gladish/esp32_bike_taillight/README.md

# bikelight
ESP32 Bike Rear Light

Watch the demo (https://www.youtube.com/watch?v=3QLlCa5cVGc)

<table>
  <tr>
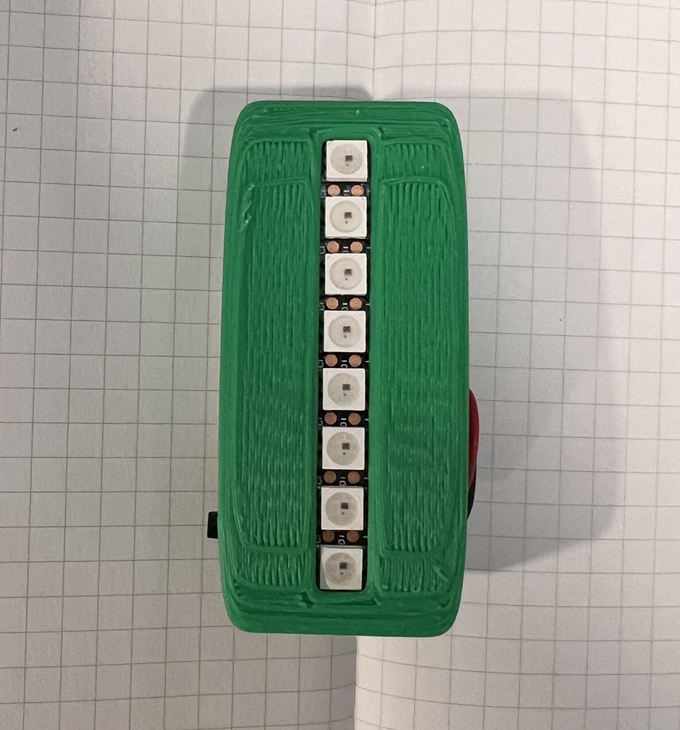
[picture p1: docs/bike_light_front.png]
    <td><br>Front</td>
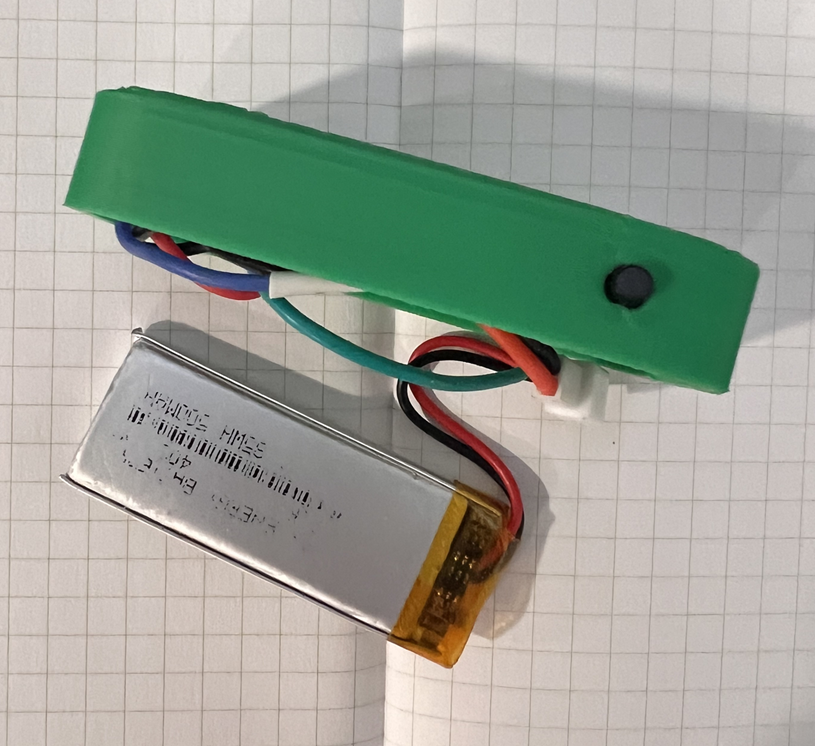
[picture p2: docs/bike_light_side.png]
    <td><br>Side</td>
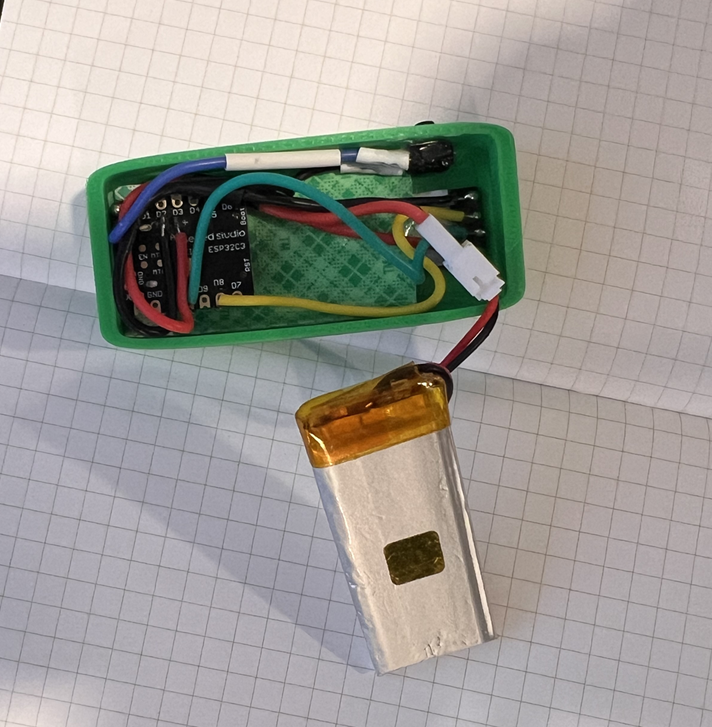
[picture p3: docs/bike_light_back.png]
    <td><br>Back</td>
  </tr>
</table>
