gladish/esp32_bike_taillight/hardware/bike_light_schematic.pdf

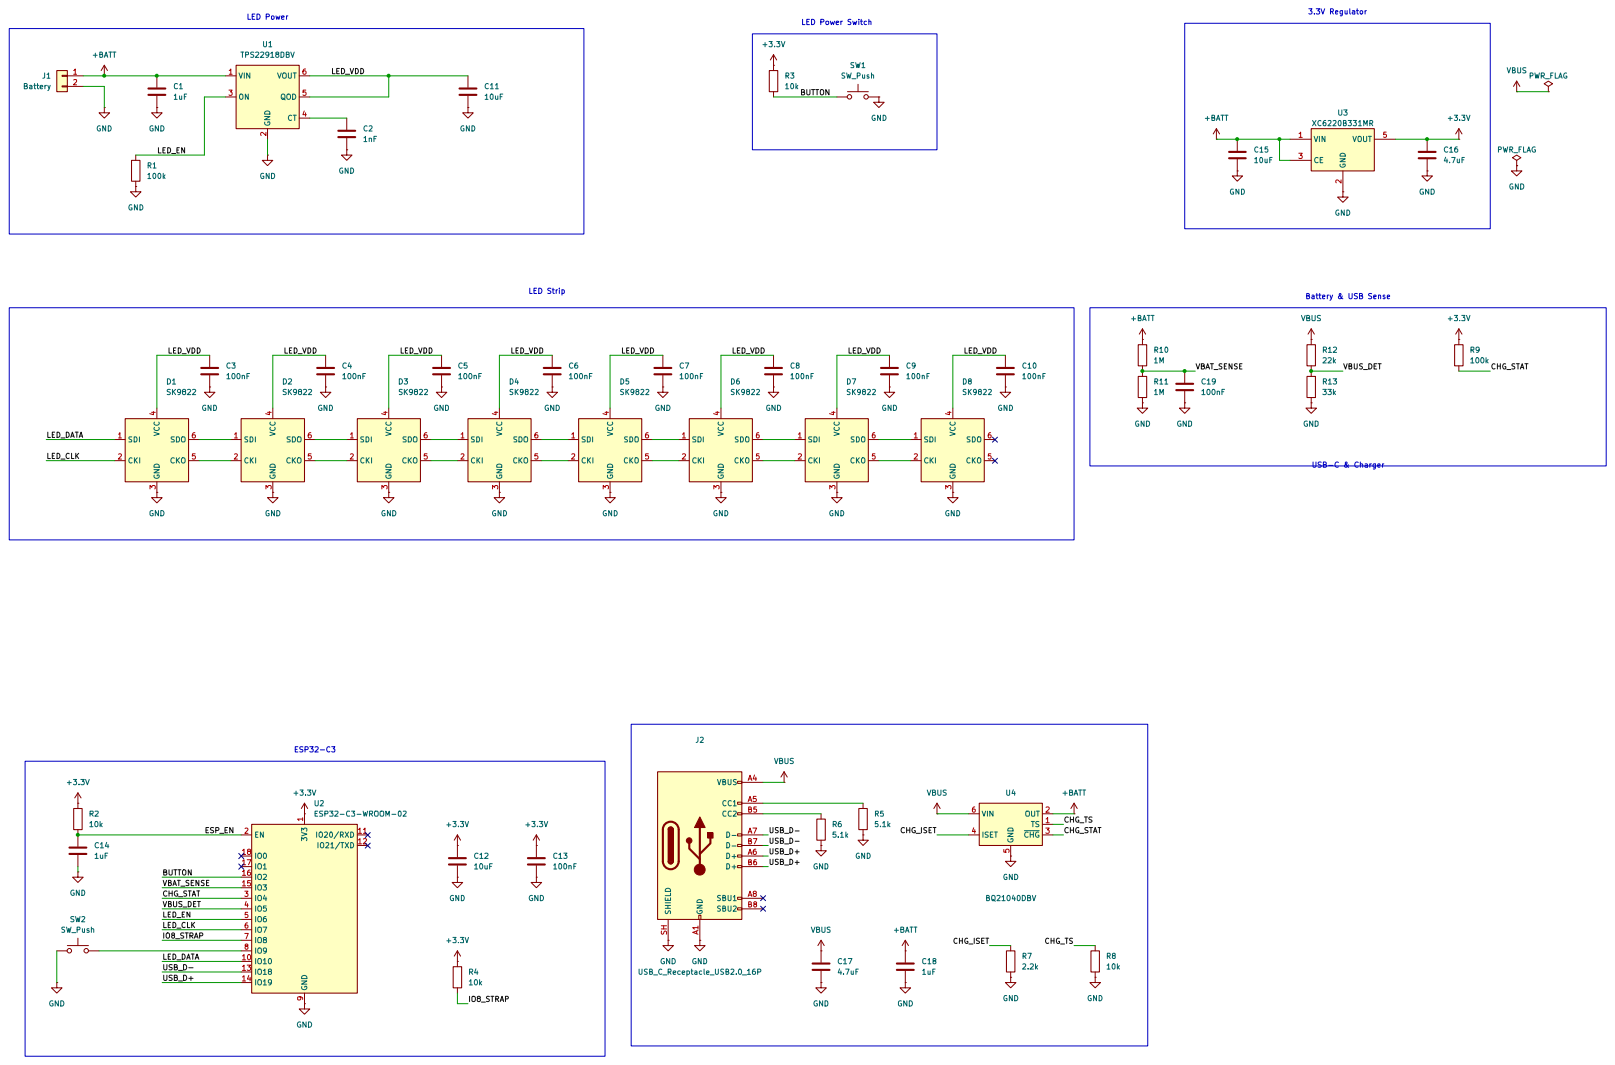
[picture p4: page 1]
