gladish/esp32_bike_taillight/hardware/bike_light/bike_light.kicad_pcb

## KiCad design hardware/bike_light/bike_light.kicad_pcb (2026-10-22)

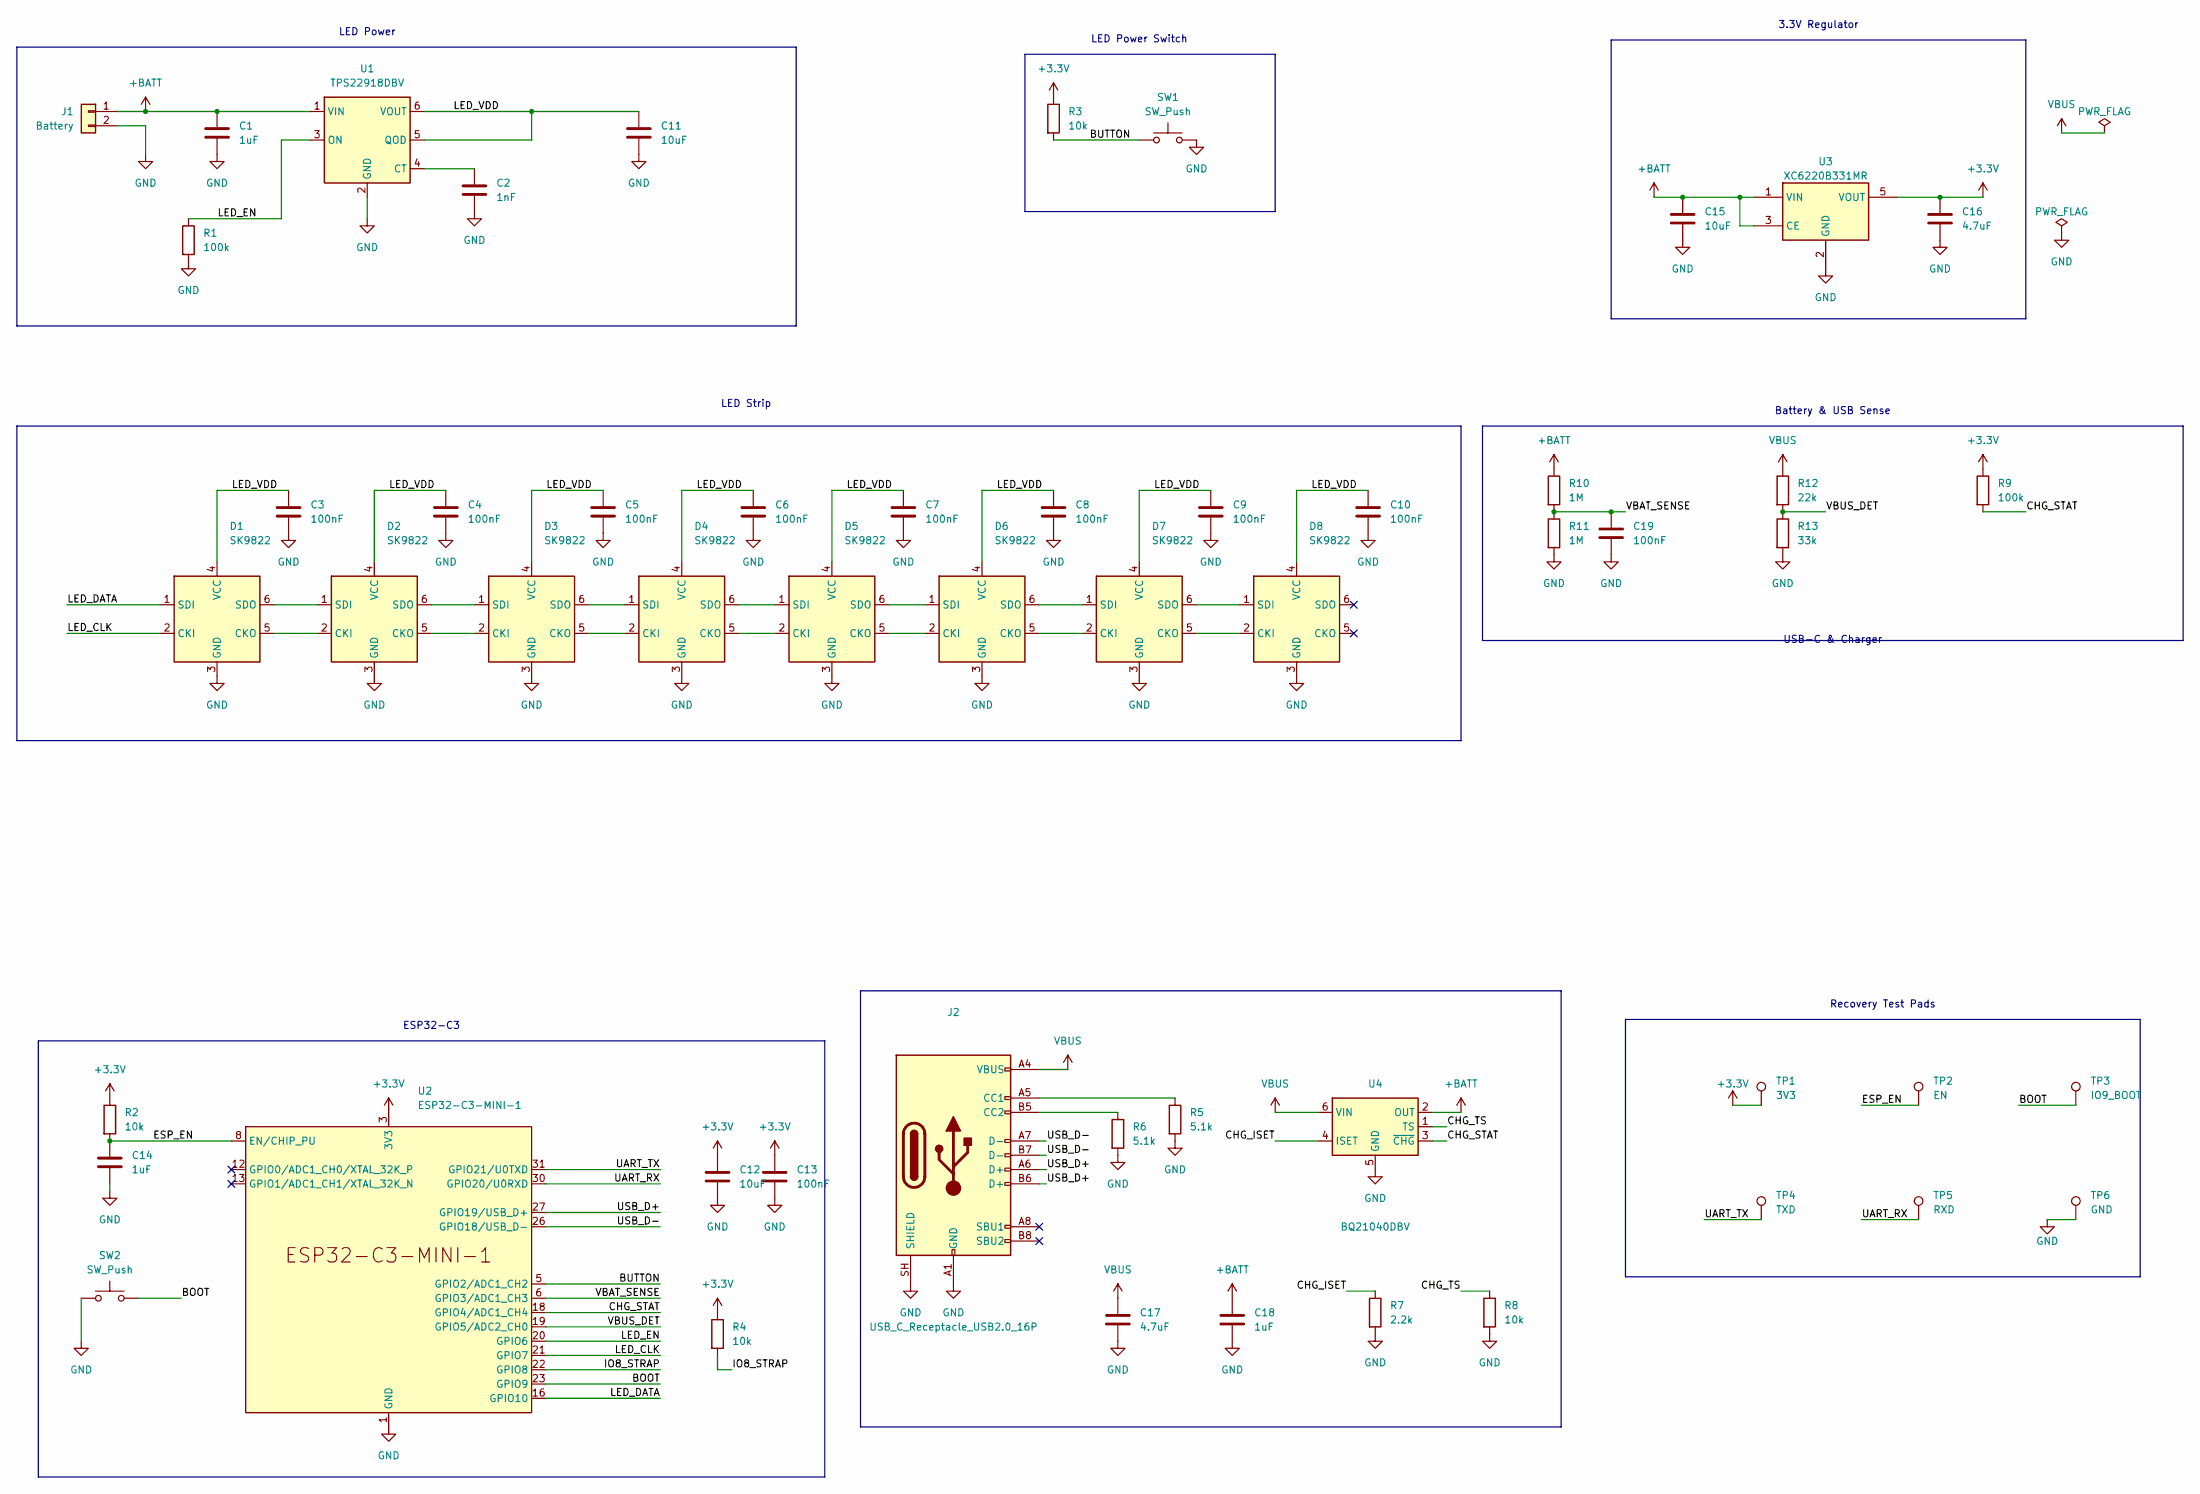
[picture p5: schematic bike_light.kicad_sch, gladish_bl]

Parts:
C1, C14, C18: 1uF; C_0402_1005Metric
C2: 1nF; C_0402_1005Metric
C3, C4, C5, C6, C7, C8, C9, C10, C13, C19: 100nF; C_0402_1005Metric
C11, C12, C15: 10uF; C_0603_1608Metric
C16, C17: 4.7uF; C_0603_1608Metric
D1, D2, D3, D4, D5, D6, D7, D8: SK9822; LED_RGB_5050-6
J1: Battery; JST_SH_SM02B-SRSS-TB_1x02-1MP_P1.00mm_Horizontal
J2: USB_C_Receptacle_USB2.0_16P; USB_C_Receptacle_HRO_TYPE-C-31-M-12
R1, R9: 100k; R_0402_1005Metric
R2, R3, R4, R8: 10k; R_0402_1005Metric
R5, R6: 5.1k; R_0402_1005Metric
R7: 2.2k; R_0402_1005Metric
R10, R11: 1M; R_0402_1005Metric
R12: 22k; R_0402_1005Metric
R13: 33k; R_0402_1005Metric
SW1: SW_Push; SW_Push_1P1T-MP_NO_Horizontal_Alps_SKRTLAE010
SW2: SW_Push; SW_SPST_B3U-1000P
TP1: 3V3; TestPoint_Pad_D1.0mm
TP2: EN; TestPoint_Pad_D1.0mm
TP3: IO9_BOOT; TestPoint_Pad_D1.0mm
TP4: TXD; TestPoint_Pad_D1.0mm
TP5: RXD; TestPoint_Pad_D1.0mm
TP6: GND; TestPoint_Pad_D1.0mm
U1: TPS22918DBV; SOT-23-6
U2: ESP32-C3-MINI-1
U3: XC6220B331MR; SOT-23-5
U4: BQ21040DBV; SOT-23-6

Connections:
+3.3V: C12.1, C13.1, C16.1, R2.1, R3.1, R4.1, R9.1, TP1.1 (1_1), U2.3 (3V3), U3.5 (VOUT)
+BATT: C1.1, C15.1, C18.1, J1.1, R10.1, U1.1 (VIN), U3.1 (VIN), U3.3 (CE), U4.2 (OUT)
/BOOT: SW2.2, TP3.1 (1_1), U2.23 (GPIO9)
/BUTTON: R3.2, SW1.1, U2.5 (GPIO2/ADC1_CH2)
/CHG_ISET: R7.1, U4.4 (ISET)
/CHG_STAT: R9.2, U2.18 (GPIO4/ADC1_CH4), U4.3 (~CHG)
/CHG_TS: R8.1, U4.1 (TS)
/ESP_EN: C14.1, R2.2, TP2.1 (1_1), U2.8 (EN/CHIP_PU)
/IO8_STRAP: R4.2, U2.22 (GPIO8)
/LED_CLK: D1.2 (CKI), U2.21 (GPIO7)
/LED_DATA: D1.1 (SDI), U2.16 (GPIO10)
/LED_EN: R1.1, U1.3 (ON), U2.20 (GPIO6)
/LED_VDD: C3.1, C4.1, C5.1, C6.1, C7.1, C8.1, C9.1, C10.1, C11.1, D1.4 (VCC), D2.4 (VCC), D3.4 (VCC), D4.4 (VCC), D5.4 (VCC), D6.4 (VCC), D7.4 (VCC), D8.4 (VCC), U1.5 (QOD), U1.6 (VOUT)
/UART_RX: TP5.1 (1_1), U2.30 (GPIO20/U0RXD)
/UART_TX: TP4.1 (1_1), U2.31 (GPIO21/U0TXD)
/USB_D+: J2.A6 (D+), J2.B6 (D+), U2.27 (GPIO19/USB_D+)
/USB_D-: J2.A7 (D-), J2.B7 (D-), U2.26 (GPIO18/USB_D-)
/VBAT_SENSE: C19.1, R10.2, R11.1, U2.6 (GPIO3/ADC1_CH3)
/VBUS_DET: R12.2, R13.1, U2.19 (GPIO5/ADC2_CH0)
GND: C1.2, C2.2, C3.2, C4.2, C5.2, C6.2, C7.2, C8.2, C9.2, C10.2, C11.2, C12.2, C13.2, C14.2, C15.2, C16.2, C17.2, C18.2, C19.2, D1.3 (GND), D2.3 (GND), D3.3 (GND), D4.3 (GND), D5.3 (GND), D6.3 (GND), D7.3 (GND), D8.3 (GND), J1.2, J2.A1 (GND), J2.A12 (GND), J2.B1 (GND), J2.B12 (GND), J2.SH (SHIELD), R1.2, R5.2, R6.2, R7.2, R8.2, R11.2, R13.2, SW1.2, SW2.1, TP6.1 (1_1), U1.2 (GND), U2.1 (GND), U2.2 (GND), U2.11 (GND), U2.14 (GND), U2.36 (GND), U2.37 (GND), U2.38 (GND), U2.39 (GND), U2.40 (GND), U2.41 (GND), U2.42 (GND), U2.43 (GND), U2.44 (GND), U2.45 (GND), U2.46 (GND), U2.47 (GND), U2.48 (GND), U2.49 (GND), U2.50 (GND), U2.51 (GND), U2.52 (GND), U2.53 (GND), U3.2 (GND), U4.5 (GND)
unnamed: D1.5 (CKO), D2.2 (CKI)
unnamed: D1.6 (SDO), D2.1 (SDI)
unnamed: D2.5 (CKO), D3.2 (CKI)
unnamed: D2.6 (SDO), D3.1 (SDI)
unnamed: D3.5 (CKO), D4.2 (CKI)
unnamed: D3.6 (SDO), D4.1 (SDI)
unnamed: D4.5 (CKO), D5.2 (CKI)
unnamed: D4.6 (SDO), D5.1 (SDI)
unnamed: D5.5 (CKO), D6.2 (CKI)
unnamed: D5.6 (SDO), D6.1 (SDI)
unnamed: D6.5 (CKO), D7.2 (CKI)
unnamed: D6.6 (SDO), D7.1 (SDI)
unnamed: D7.5 (CKO), D8.2 (CKI)
unnamed: D7.6 (SDO), D8.1 (SDI)
unnamed: J2.A5 (CC1), R5.1
unnamed: J2.B5 (CC2), R6.1
unnamed: C2.1, U1.4 (CT)
VBUS: C17.1, J2.A4 (VBUS), J2.A9 (VBUS), J2.B4 (VBUS), J2.B9 (VBUS), R12.1, U4.6 (VIN)

Notes on the sheet:
LED Power Switch
LED Strip
3.3V Regulator
Recovery Test Pads
Battery & USB Sense
ESP32-C3
USB-C & Charger
LED Power

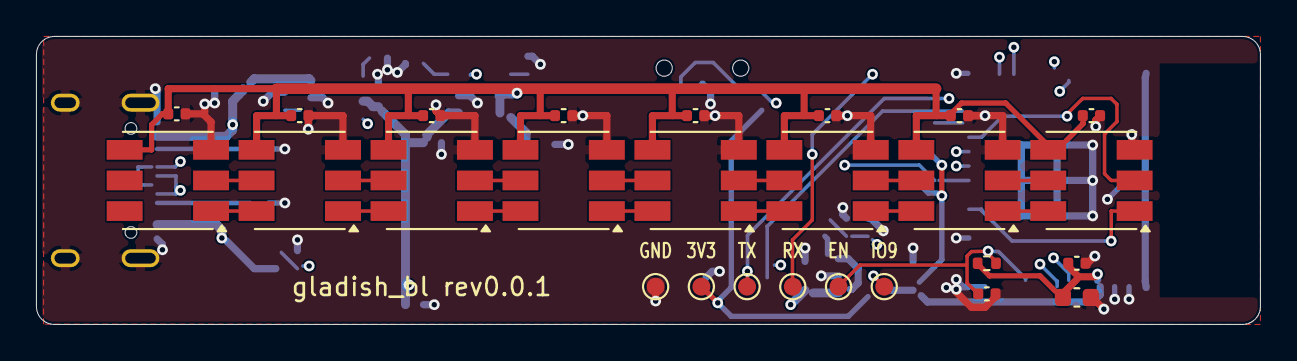
[picture p6: board bike_light.kicad_pcb from above]

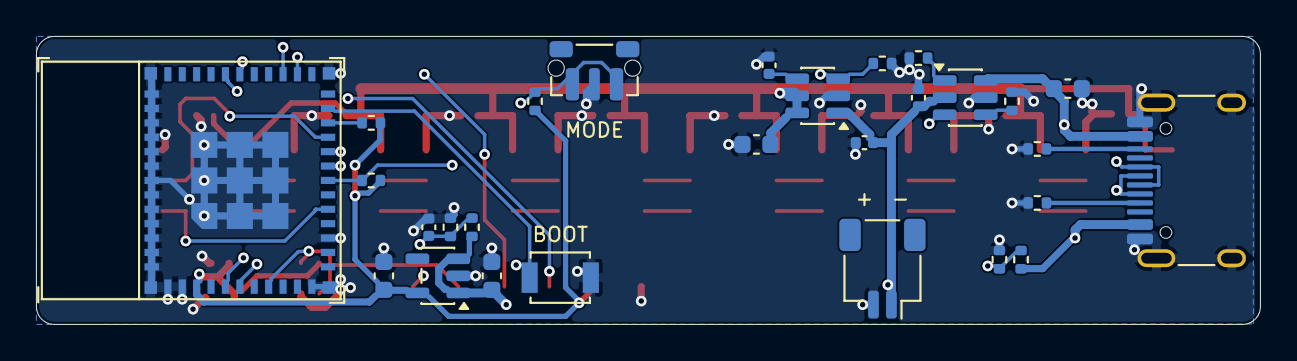
[picture p7: board bike_light.kicad_pcb from below]

Board: 4 copper layers, 68.0 x 16.0 mm, 54 parts (28 on the bottom side), 38 nets.
