gladish/esp32_bike_taillight/(commit log)

2026-05-20 Replaced deprecated sleep function. Turned brightness down
    [main.cpp]
2026-05-24 Refactored int LedPatterns
2026-09-04 Renemed LedPattern -> led_renderer.[cpp|h]
2026-10-15 Added PDF printed schematic
2026-10-16 PCB updates
    * Added USB step file
    * Added side push button step file
    * Moved debug pads for cleaner layout
    * Added some silkscreening with model name/version.
2026-10-16 Updated PCB and new models
2026-10-17 Moved button away from edge a bit
2026-10-17 Moved USB connector to bottom from side
2026-10-21 Switched to ESP32-C3-MINI-1, shrunk board
